Choomek/zadanieRekrutacyjneFalcon292778/zadanieRekrutacyjneFalcon292778.kicad_pcb

## KiCad design zadanieRekrutacyjneFalcon292778.kicad_pcb (2026-03-28)

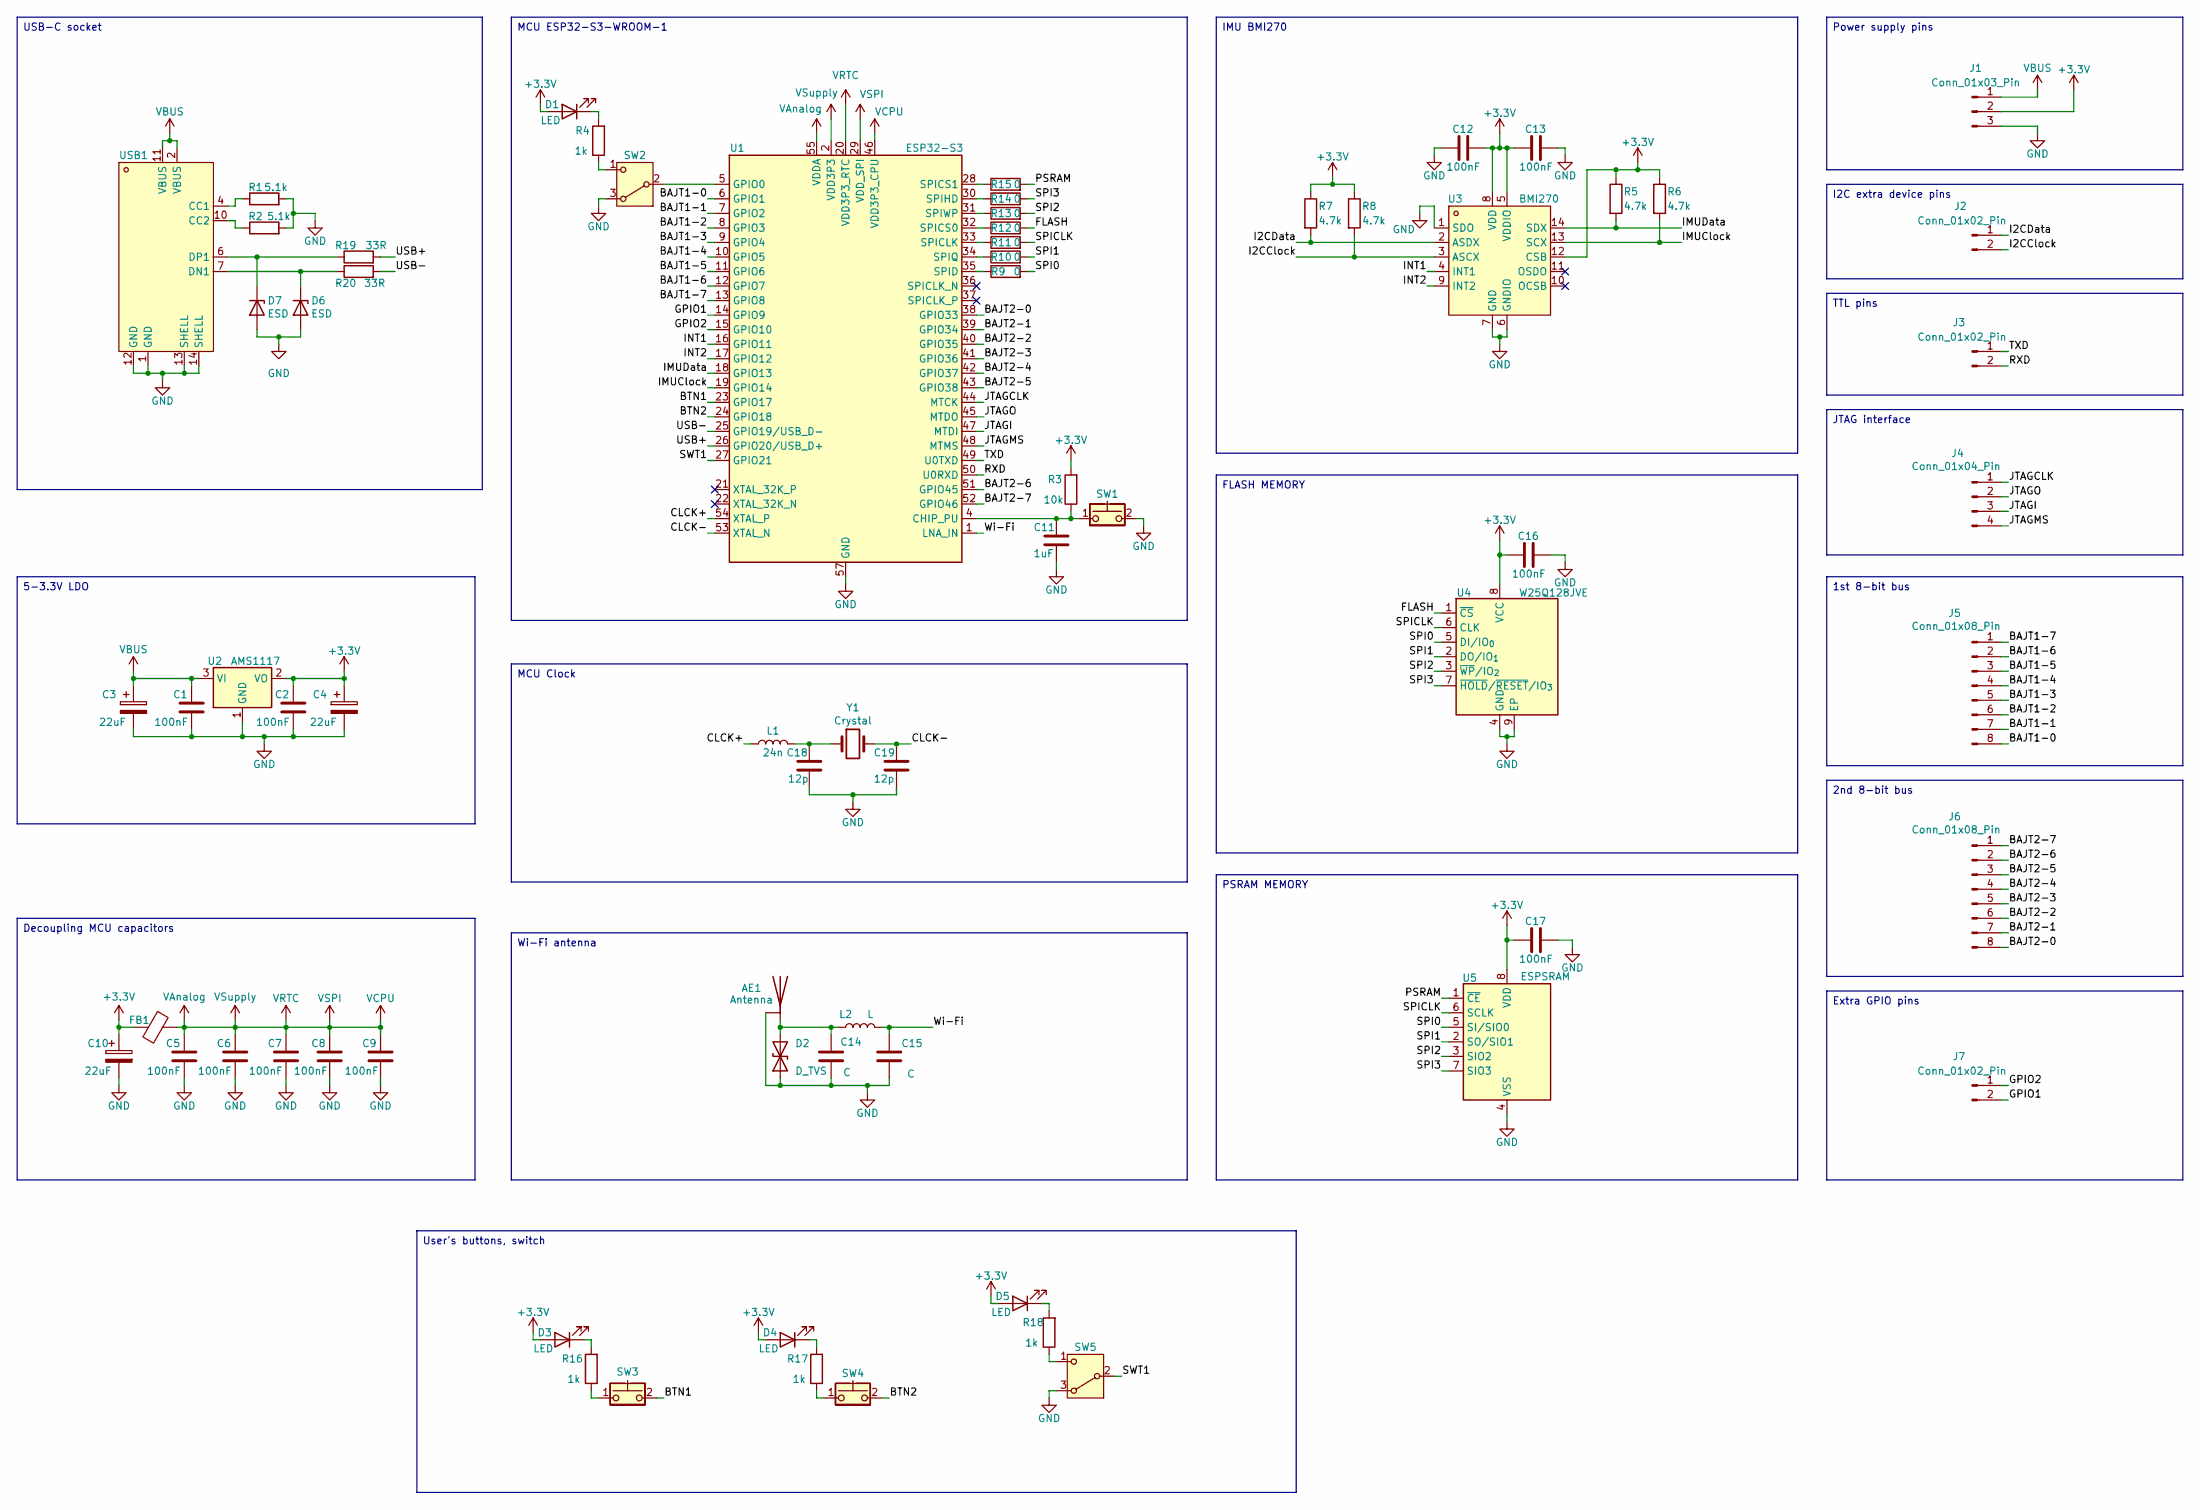
[picture p10: schematic zadanieRekrutacyjneFalcon292778.kicad_sch]

Parts:
AE1: Antenna; Texas_SWRA117D_2.4GHz_Right
C1, C2, C5, C6, C7, C8, C9, C12, C13, C16, C17: 100nF; C_0603_1608Metric
C3, C4, C10: 22uF; CP_Axial_L11.0mm_D5.0mm_P18.00mm_Horizontal
C11: 1uF; C_0603_1608Metric
C14, C15: C; C_0603_1608Metric
C18, C19: 12p; C_0603_1608Metric
D1, D3, D4, D5: LED; LED_0603_1608Metric
D2: D_TVS; Texas_DPY0002A_0.6x1mm_P0.65mm
D6, D7: ESD; D_SOD-523
FB1: FerriteBead; LairdTech_28C0236-0JW-10
J1: Conn_01x03_Pin; PinHeader_1x03_P2.54mm_Vertical
J2, J3, J7: Conn_01x02_Pin; PinHeader_1x02_P2.54mm_Vertical
J4: Conn_01x04_Pin; PinHeader_1x04_P2.54mm_Vertical
J5, J6: Conn_01x08_Pin; PinHeader_1x08_P2.54mm_Vertical
L1: 24n; L_0603_1608Metric
L2: L; L_0603_1608Metric
R1, R2: 5.1k; R_0603_1608Metric
R3: 10k; R_0603_1608Metric
R4, R16, R17, R18: 1k; R_0603_1608Metric
R5, R6, R7, R8: 4.7k; R_0603_1608Metric
R9, R10, R11, R12, R13, R14, R15: 0; R_0603_1608Metric
R19, R20: 33R; R_0603_1608Metric
SW1, SW3, SW4: CK_KMS2xxG; SW_SPST_CK_KMS2xxGP
SW2, SW5: SW_Nidec_CAS-120A1; Nidec_Copal_CAS-120A
U1: ESP32-S3; QFN-56-1EP_7x7mm_P0.4mm_EP4x4mm
U2: AMS1117; SOT-223-3_TabPin2
U3: BMI270; LGA-14_L3.0-W2.5-P0.50-BR; LCSC Part C2836813
U4: W25Q128JVE; WSON-8-1EP_8x6mm_P1.27mm_EP3.4x4.3mm
U5: ESPSRAM; SOIC-8_3.9x4.9mm_P1.27mm
USB1: TYPE-C 16PIN 2MD(073); USB-C-SMD_TYPE-C-6PIN-2MD-073; LCSC Part C2765186
Y1: Crystal; Resonator-2Pin_W7.0mm_H2.5mm

Connections:
+3.3V: C2.1, C4.1, C10.1, C12.1, C13.2, C16.2, C17.2, D1.2 (A), D3.2 (A), D4.2 (A), D5.2 (A), FB1.2, J1.2, R3.2, R5.1, R6.1, R7.1, R8.1, U2.2 (VO), U3.5 (VDDIO), U3.8 (VDD), U3.12 (CSB), U4.8 (VCC), U5.8 (VDD)
/BAJT1-0: J5.8, U1.6 (GPIO1)
/BAJT1-1: J5.7, U1.7 (GPIO2)
/BAJT1-2: J5.6, U1.8 (GPIO3)
/BAJT1-3: J5.5, U1.9 (GPIO4)
/BAJT1-4: J5.4, U1.10 (GPIO5)
/BAJT1-5: J5.3, U1.11 (GPIO6)
/BAJT1-6: J5.2, U1.12 (GPIO7)
/BAJT1-7: J5.1, U1.13 (GPIO8)
/BAJT2-0: J6.8, U1.38 (GPIO33)
/BAJT2-1: J6.7, U1.39 (GPIO34)
/BAJT2-2: J6.6, U1.40 (GPIO35)
/BAJT2-3: J6.5, U1.41 (GPIO36)
/BAJT2-4: J6.4, U1.42 (GPIO37)
/BAJT2-5: J6.3, U1.43 (GPIO38)
/BAJT2-6: J6.2, U1.51 (GPIO45)
/BAJT2-7: J6.1, U1.52 (GPIO46)
/BTN1: SW3.2, U1.23 (GPIO17)
/BTN2: SW4.2, U1.24 (GPIO18)
/CLCK+: L1.1, U1.54 (XTAL_P)
/CLCK-: C19.1, U1.53 (XTAL_N), Y1.2
/FLASH: R12.2, U4.1 (~CS)
/GPIO1: J7.2, U1.14 (GPIO9)
/GPIO2: J7.1, U1.15 (GPIO10)
/I2CClock: J2.2, R8.2, U3.3 (ASCX)
/I2CData: J2.1, R7.2, U3.2 (ASDX)
/IMUClock: R6.2, U1.19 (GPIO14), U3.13 (SCX)
/IMUData: R5.2, U1.18 (GPIO13), U3.14 (SDX)
/INT1: U1.16 (GPIO11), U3.4 (INT1)
/INT2: U1.17 (GPIO12), U3.9 (INT2)
/JTAGCLK: J4.1, U1.44 (MTCK)
/JTAGI: J4.3, U1.47 (MTDI)
/JTAGMS: J4.4, U1.48 (MTMS)
/JTAGO: J4.2, U1.45 (MTDO)
/PSRAM: R15.2, U5.1 (~CE)
/RXD: J3.2, U1.50 (U0RXD)
/SPI0: R9.2, U4.5 (DI/IO_{0}), U5.5 (SI/SIO0)
/SPI1: R10.2, U4.2 (DO/IO_{1}), U5.2 (SO/SIO1)
/SPI2: R13.2, U4.3 (~WP/IO_{2}), U5.3 (SIO2)
/SPI3: R14.2, U4.7 (~HOLD/~RESET/IO_{3}), U5.7 (SIO3)
/SPICLK: R11.2, U4.6 (CLK), U5.6 (SCLK)
/SWT1: SW5.2 (B), U1.27 (GPIO21)
/TXD: J3.1, U1.49 (U0TXD)
/USB+: R19.2, U1.26 (GPIO20/USB_D+)
/USB-: R20.2, U1.25 (GPIO19/USB_D-)
/Wi-Fi: C15.1, L2.2, U1.1 (LNA_IN)
GND: AE1.2 (GND), C1.2, C2.2, C3.2, C4.2, C5.2, C6.2, C7.2, C8.2, C9.2, C10.2, C11.2, C12.2, C13.1, C14.2, C15.2, C16.1, C17.1, C18.2, C19.2, D2.1 (A1), D6.2 (A), D7.2 (A), J1.3, R1.2, R2.2, SW1.2, SW2.3 (A), SW5.3 (A), U1.57 (GND), U2.1 (GND), U3.1 (SDO), U3.6 (GNDIO), U3.7 (GND), U4.4 (GND), U4.9 (EP), U5.4 (VSS), USB1.1 (GND), USB1.12 (GND), USB1.13 (SHELL), USB1.14 (SHELL)
unnamed: AE1.1 (A), C14.1, D2.2 (A2), L2.1
unnamed: C18.1, L1.2, Y1.1
unnamed: D1.1 (K), R4.2
unnamed: D3.1 (K), R16.2
unnamed: D4.1 (K), R17.2
unnamed: D5.1 (K), R18.2
unnamed: D6.1 (K), R20.1, USB1.7 (DN1)
unnamed: D7.1 (K), R19.1, USB1.6 (DP1)
unnamed: R16.1, SW3.1
unnamed: R17.1, SW4.1
unnamed: SW2.2 (B), U1.5 (GPIO0)
unnamed: R4.1, SW2.1 (C)
unnamed: R18.1, SW5.1 (C)
unnamed: C11.1, R3.1, SW1.1, U1.4 (CHIP_PU)
unnamed: R11.1, U1.33 (SPICLK)
unnamed: R12.1, U1.32 (SPICS0)
unnamed: R15.1, U1.28 (SPICS1)
unnamed: R9.1, U1.35 (SPID)
unnamed: R14.1, U1.30 (SPIHD)
unnamed: R10.1, U1.34 (SPIQ)
unnamed: R13.1, U1.31 (SPIWP)
unnamed: R1.1, USB1.4 (CC1)
unnamed: R2.1, USB1.10 (CC2)
VAnalog: C5.1, C6.1, C7.1, C8.1, C9.1, FB1.1, U1.2 (VDD3P3), U1.3 (VDD3P3), U1.20 (VDD3P3_RTC), U1.29 (VDD_SPI), U1.46 (VDD3P3_CPU), U1.55 (VDDA), U1.56 (VDDA)
VBUS: C1.1, C3.1, J1.1, U2.3 (VI), USB1.2 (VBUS), USB1.11 (VBUS)

Notes on the sheet:
2nd 8-bit bus
Wi-Fi antenna
IMU BMI270
Decoupling MCU capacitors
USB-C socket
TTL pins
MCU ESP32-S3-WROOM-1
Power supply pins
1st 8-bit bus
PSRAM MEMORY
5-3.3V LDO
FLASH MEMORY
JTAG interface
Extra GPIO pins
User's buttons, switch
I2C extra device pins
MCU Clock

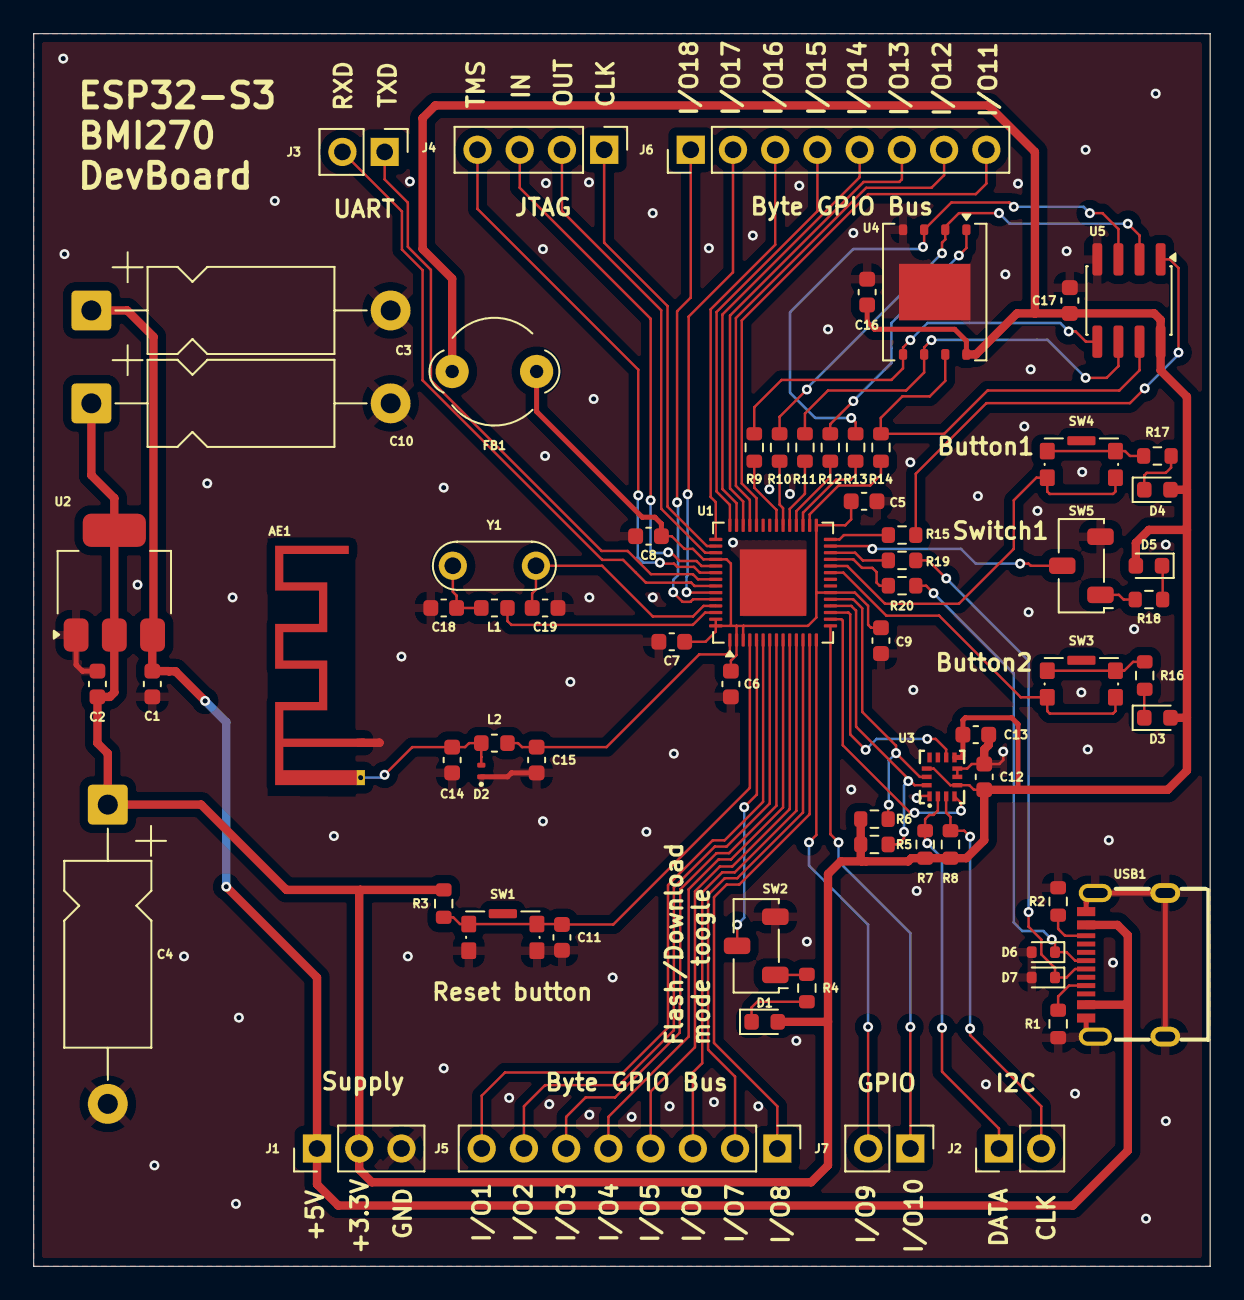
[picture p11: board zadanieRekrutacyjneFalcon292778.kicad_pcb from above]

Board: 2 copper layers, 70.8 x 74.1 mm, 69 parts (0 on the bottom side), 72 nets.
