Choomek/zadanieRekrutacyjneFalcon292778/(commit log)

2026-03-24 schemat + footprinty v1
    [zadanieRekrutacyjneFalcon292778.kicad_pcb, zadanieRekrutacyjneFalcon292778.kicad_sch]
2026-03-24 schemat + footprinty v2
2026-03-24 placement + testowy tracking v1
    [zadanieRekrutacyjneFalcon292778.kicad_pcb, zadanieRekrutacyjneFalcon292778.kicad_sch]
2026-03-25 zroutowane (do poprawy footprinty, DRC)
    [zadanieRekrutacyjneFalcon292778.kicad_pcb, zadanieRekrutacyjneFalcon292778.kicad_sch]
2026-03-27 DRC naprawione 3d modele dodane, transile dodane
    [zadanieRekrutacyjneFalcon292778.kicad_pcb, zadanieRekrutacyjneFalcon292778.kicad_sch]
2026-03-28 Finalna wersja v1
    [zadanieRekrutacyjneFalcon292778.kicad_pcb, zadanieRekrutacyjneFalcon292778.kicad_sch]
2026-03-28 Finalna wersja v2 (gerbery)
    [zadanieRekrutacyjneFalcon292778-B_Cu.gbr, zadanieRekrutacyjneFalcon292778-B_Mask.gbr, zadanieRekrutacyjneFalcon292778-B_Paste.gbr, zadanieRekrutacyjneFalcon292778-B_Silkscreen.gbr, zadanieRekrutacyjneFalcon292778-Edge_Cuts.gbr, zadanieRekrutacyjneFalcon292778-F_Cu.gbr, zadanieRekrutacyjneFalcon292778-F_Mask.gbr, zadanieRekrutacyjneFalcon292778-F_Paste.gbr]
2026-03-28 Finalna wersja v3
    [zadanieRekrutacyjneFalcon292778.kicad_pcb]
